pjclavero/Diana/hardware/electronics/schematics/02-esp32-w5500.md

# Hoja 02 — ESP32-S3 y Ethernet W5500

> **SIN VALIDAR.** ERC no ejecutado. Dosier §8.2, §8.3, §8.4, §12 y §28.2.
> El pinout depende del cálculo [`03-presupuesto-gpio.md`](../calculations/03-presupuesto-gpio.md),
> que concluye que **la topología literal del dosier §8.4 no cabe** y adopta la
> topología B.

## 1. Lista de componentes

| Ref. | Valor / tipo | Encapsulado | Función |
|---|---|---|---|
| **U10** | **ESP32-S3-WROOM-1-N16R8** (16 MB flash, 8 MB PSRAM octal) | Módulo SMD | Controlador **(V)**: confirmar variante de PSRAM, ver cálculo 03 §1.2 |
| **U11** | **W5500** | LQFP-48 | Controlador Ethernet con pila TCP/IP |
| Y1 | Cristal **25,000 MHz**, ±30 ppm, C_L 12 pF | 3225 | Reloj del W5500 (obligatorio) |
| C20, C21 | 22 pF NP0 | 0603 | Carga de Y1. **(V)** ajustar tras medir la frecuencia real |
| R20 | 10 kΩ | 0603 | Pull-up de `W5500_RSTn` |
| R21 | 10 kΩ | 0603 | Pull-up de `W5500_INTn` (salida en colector abierto) |
| C22 | 100 nF | 0603 | RC de reset del W5500 con R20: τ = 1,0 ms > 500 µs exigidos |
| R22, R23, R24 | 22 Ω | 0603 | Serie en SCLK, MOSI y nCS_W5500 (control de flancos, EMI) |
| R25–R28 | **49,9 Ω 1 %** | 0603 | Terminación de los pares TX y RX (4 unidades) |
| C23 | **10 nF / 2 kV** X7R | 1206 | Terminación Bob Smith: nodo común de las 4 terminaciones → `CHASSIS` |
| D20 | Array TVS 4 canales para Ethernet, C ≤ 3 pF, ej. SP3012-04UTG | SOT-23-6 | Protección ESD del puerto (dosier §8.3) |
| L20 | Ferrita 600 Ω @ 100 MHz | 0805 | Aísla el 3,3 V del W5500 |
| C24–C31 | 8 × 100 nF | 0402/0603 | Desacoplo, **uno por pin de alimentación del W5500** |
| C32 | 22 µF / 10 V X7R | 0805 | Bulk local del W5500 |
| C33 | 10 µF / 10 V X7R | 0805 | Bulk local del ESP32-S3 |
| C34, C35 | 100 nF | 0402 | Desacoplo del ESP32-S3, junto a cada pin 3V3 |
| R29 | 10 kΩ | 0603 | Pull-up de `EN` del ESP32-S3 |
| C36 | 1 µF | 0603 | RC de `EN`: τ = 10 kΩ × 1 µF = **10 ms** |
| R30 | 10 kΩ | 0603 | Pull-up de `IO0` (BOOT) |
| C37 | 100 nF | 0603 | Antirrebote de SW_BOOT |
| SW_RST | Pulsador táctil 6×6 mm | THT/SMD | Reset |
| SW_BOOT | Pulsador táctil 6×6 mm | THT/SMD | Descarga de firmware |
| R31 | 10 kΩ | 0603 | Pull-up de `IO45` a masa — **VÉASE NOTA CRÍTICA §4** |
| J2 | RJ45 con magnetismos integrados y LED (HR911105A o J0011D01BNL) | THT | Puerto Ethernet (en hoja 08) |
| TP10–TP19 | Pin de prueba | THT | ver §6 |

## 2. Conexionado — bus SPI compartido

El W5500 y el ADC externo de la hoja 05 **comparten** SCLK/MOSI/MISO. El
arbitraje es por chip select.

| Red | ESP32-S3 | W5500 | ADC (hoja 05) | Serie |
|---|---|---|---|---|
| `SPI_SCLK` | IO12 | SCLK (pin 32) | SCLK | R22 22 Ω |
| `SPI_MOSI` | IO11 | MOSI (pin 33) | DIN | R23 22 Ω |
| `SPI_MISO` | IO13 | MISO (pin 34) | DOUT | — |
| `nCS_W5500` | IO10 | SCSn (pin 31) | — | R24 22 Ω |
| `nCS_ADC` | IO14 | — | CSn | — |
| `W5500_INTn` | IO9 | INTn (pin 30) | — | pull-up R21 10 kΩ |
| `W5500_RSTn` | IO8 | RSTn (pin 29) | — | pull-up R20 10 kΩ + C22 100 nF |

**Velocidad de reloj SPI adoptada: 20 MHz.** El W5500 admite hasta 33,3 MHz
según hoja de datos, pero con dos esclavos en el mismo bus y pistas no
controladas en impedancia, 20 MHz da margen. **(V)** Verificar la integridad de
la señal con analizador lógico y, si es necesario, bajar a 10 MHz.

**Requisito de reset del W5500:** RSTn debe mantenerse bajo ≥ 500 µs. El RC
R20/C22 da τ = 1,0 ms al arrancar, y además `IO8` puede forzarlo por firmware.

## 3. Interfaz completa del ESP32-S3 (topología B)

| GPIO | Red | Dirección | Destino |
|---:|---|---|---|
| IO1 | `VSENSE_12V` | entrada ADC1_CH0 | hoja 01 |
| IO2 | *reserva* | — | pin de prueba TP19 |
| IO4 | `LED_D1_3V3` | salida (RMT) | hoja 06, fila superior |
| IO5 | `LED_D2_3V3` | salida (RMT) | hoja 06, fila central |
| IO6 | `LED_D3_3V3` | salida (RMT) | hoja 06, fila inferior |
| IO7 | `IRQ_ANY` | entrada, IRQ por flanco de bajada | hoja 04 |
| IO8 | `W5500_RSTn` | salida | U11 |
| IO9 | `W5500_INTn` | entrada | U11 |
| IO10 | `nCS_W5500` | salida | U11 |
| IO11 | `SPI_MOSI` | salida | U11, hoja 05 |
| IO12 | `SPI_SCLK` | salida | U11, hoja 05 |
| IO13 | `SPI_MISO` | entrada | U11, hoja 05 |
| IO14 | `nCS_ADC` | salida | hoja 05 |
| IO15 | `SEL_A` | entrada, pull-up | hoja 07 |
| IO16 | `SEL_B` | entrada, pull-up | hoja 07 |
| IO17 | `BTN_ID` | entrada, pull-up | hoja 07 |
| IO18 | `ST_LED_G` | salida | hoja 07 |
| IO21 | `VREF_TH_PWM` | salida PWM | hoja 04, filtro RC → umbral |
| IO38 | `SR_DATA` | entrada | hoja 04 (QH del 74HC165) |
| IO39 | `ST_LED_A` | salida | hoja 07. **Consume MTCK** |
| IO47 | `SR_LOAD` | salida | hoja 04 |
| IO48 | `SR_CLK` | salida | hoja 04 |
| IO40, IO41, IO42 | *reserva* | — | pines de prueba TP16–TP18. **Son JTAG** |
| IO19, IO20 | **libres** | USB-Serial-JTAG nativo | no llevados a ningún sitio |
| IO43, IO44 | U0TXD / U0RXD | — | cabezal de programación J30 (hoja 08) |
| IO0 | BOOT | — | R30 + SW_BOOT + C37 |
| EN | RESET | — | R29 + C36 + SW_RST |
| IO3, IO45, IO46 | **no usados** | strapping | ver §4 |
| IO35, IO36, IO37 | **no usados** | PSRAM octal | ver §4 |

## 4. NOTA CRÍTICA sobre pines de arranque

| Pin | Estado exigido en el arranque | Implementación |
|---|---|---|
| `IO0` | Alto para arranque normal; bajo para descarga | R30 pull-up 10 kΩ a `+3V3`, SW_BOOT a `GND_LOG`, C37 100 nF |
| `EN` | Bajo ≥ 1 ms y luego alto | R29 10 kΩ a `+3V3` + C36 1 µF ⇒ τ = 10 ms |
| `IO45` (`VDD_SPI`) | **BAJO** (flash de 3,3 V) | **No conectar nada** y **añadir R31 = 10 kΩ a `GND_LOG`** para garantizarlo |
| `IO46` | Bajo en el arranque | No conectar. Pull-down interno del módulo **(V)**: confirmar en hoja de datos |
| `IO3` | Indiferente si el eFuse de JTAG está por defecto | No conectar |
| `IO35`, `IO36`, `IO37` | Dedicados a la PSRAM octal | **NO CONECTAR NADA.** Rutarlos destruye el arranque |

**Este cuadro es una de las causas típicas de que una placa nueva no arranque.
Debe reverificarse contra la hoja de datos de la revisión exacta del módulo
adquirido antes de fabricar (V).**

## 5. Ethernet — capa física

### 5.1 Conexionado de los pares

| Red | W5500 | R terminación | J2 (RJ45) | D20 |
|---|---|---|---|---|
| `ETH_TXP` | TXP (pin 3) | R25 49,9 Ω → nodo `BOB` | pin 1 | canal 1 |
| `ETH_TXN` | TXN (pin 2) | R26 49,9 Ω → nodo `BOB` | pin 2 | canal 2 |
| `ETH_RXP` | RXP (pin 5) | R27 49,9 Ω → nodo `BOB` | pin 3 | canal 3 |
| `ETH_RXN` | RXN (pin 6) | R28 49,9 Ω → nodo `BOB` | pin 6 | canal 4 |
| `BOB` | — | nodo común de R25–R28 | — | → C23 (10 nF/2 kV) → `CHASSIS` |

Terminación **Bob Smith**: los cuatro 49,9 Ω se unen en un nodo común que se
acopla al chasis mediante C23. Esto da camino de retorno de modo común a las
corrientes del cable sin unir galvánicamente `GND_LOG` y `CHASSIS`.

Los pines 4, 5, 7 y 8 del RJ45 (pares no usados en 10/100BASE-T) se terminan con
75 Ω a un nodo común acoplado por otro condensador de 10 nF/2 kV a `CHASSIS`.
**(V)** — algunos RJ45 con magnetismos ya lo llevan internamente; comprobar la
hoja de datos del conector elegido antes de duplicarlo.

### 5.2 Reglas de layout obligatorias (para el WP de PCB)

1. Los pares TX y RX **diferenciales**, con impedancia diferencial de **100 Ω**,
   longitudes emparejadas dentro de **±0,5 mm** dentro de cada par.
2. Plano de masa continuo bajo los pares **hasta** los magnetismos, y **hueco**
   (sin cobre en ninguna capa) bajo y más allá de los magnetismos, hacia el lado
   del conector.
3. Separación entre los pares TX y RX ≥ 3× la anchura de pista.
4. Sin vías en los pares si es evitable.
5. Y1 con su cristal a menos de 5 mm del W5500 y con guarda de masa.
6. C24–C31 a menos de 2 mm de cada pin de alimentación.

**Ninguna de estas reglas se ha verificado: no hay layout.**

### 5.3 Alimentación del W5500

| Nodo | Conexiones |
|---|---|
| `+3V3` | → L20.1 |
| `+3V3_ETH` | L20.2 → C32 (22 µF), C24–C31 (100 nF ×8), todos los pines V_CC del W5500 |
| `GND_LOG` | Todos los pines GND del W5500 y el pad térmico |

El W5500 lleva regulador interno de 1,2 V para el núcleo; sus pines
`VDD_1V2`/`VBG` se desacoplan según la hoja de datos del fabricante **(V)**.

### 5.4 Identidad de red

El dosier §8.3 y §12.3 exigen **dirección MAC única**. El W5500 **no** trae MAC
en fábrica. Opciones:

1. **EEPROM de MAC precargada** (24AA02E48, I²C) — cuesta 2 GPIO de la reserva.
   **No hay 2 GPIO libres sin restricciones** (cálculo 03 §3.2).
2. **Derivar la MAC del MAC base de fábrica del ESP32-S3**, que sí es único y
   está en eFuse, aplicando el offset de interfaz. **RECOMENDADA:** coste cero en
   hardware y unicidad garantizada por Espressif.
3. Grabar la MAC en NVS durante la fabricación. Requiere proceso de producción.

**Adoptada la opción 2.** Debe confirmarse con WP-04 (firmware) que el MAC base
de eFuse es accesible y que se usa un OUI admisible.

## 6. Puntos de prueba

| TP | Red | Criterio de aceptación |
|---|---|---|
| TP10 | `+3V3_ETH` | 3,25 – 3,35 V, rizado < 30 mV_pp |
| TP11 | `SPI_SCLK` | Reloj limpio a 20 MHz, sobreoscilación < 0,5 V |
| TP12 | `nCS_W5500` | Pulsos válidos, nivel alto ≥ 2,6 V |
| TP13 | `W5500_INTn` | Alto en reposo, bajo con paquete pendiente |
| TP14 | `W5500_RSTn` | Bajo ≥ 500 µs al arrancar |
| TP15 | Y1 | 25,000 MHz ±30 ppm (con punta de baja capacidad) |
| TP16–TP18 | IO40–IO42 | pines de reserva accesibles |
| TP19 | IO2 | pin de reserva accesible |

## 7. Riesgos específicos de esta hoja

1. **Presupuesto de GPIO sin holgura real** (cálculo 03). Cualquier función nueva
   obliga a rediseñar.
2. **Pines de arranque:** un error aquí produce una placa que no arranca y que no
   se puede depurar fácilmente. Es el punto que más se beneficia de una revisión
   humana antes de fabricar.
3. **Integridad de señal de Ethernet** sin impedancia controlada verificada.
4. **Dos esclavos en un mismo bus SPI:** si el ADC externo o el W5500 no liberan
   correctamente MISO, se bloquea la comunicación. **(V)**
5. **Variante de PSRAM desconocida** hasta que se compre el módulo.
