pjclavero/Diana/hardware/electronics/kicad/.gitkeep.md

# hardware/electronics/kicad

Pendiente: lo rellena el paquete de trabajo propietario (ver docs/coordination/OWNERSHIP.md).
