pjclavero/Diana/hardware/electronics/schematics/.gitkeep.md

# hardware/electronics/schematics

Pendiente: lo rellena el paquete de trabajo propietario (ver docs/coordination/OWNERSHIP.md).
