pjclavero/Diana/hardware/mechanical/cad/.gitkeep.md

# hardware/mechanical/cad

Pendiente: lo rellena el paquete de trabajo propietario (ver docs/coordination/OWNERSHIP.md).
