pjclavero/Diana/docs/hardware/.gitkeep.md

# docs/hardware

Pendiente: lo rellena el paquete de trabajo propietario (ver docs/coordination/OWNERSHIP.md).
