pjclavero/Diana/hardware/electronics/calculations/.gitkeep.md

# hardware/electronics/calculations

Pendiente: lo rellena el paquete de trabajo propietario (ver docs/coordination/OWNERSHIP.md).
