pjclavero/Diana/hardware/mechanical/drawings/.gitkeep.md

# hardware/mechanical/drawings

Pendiente: lo rellena el paquete de trabajo propietario (ver docs/coordination/OWNERSHIP.md).
