pjclavero/Diana/scripts/.gitkeep.md

# scripts

Pendiente: lo rellena el paquete de trabajo propietario (ver docs/coordination/OWNERSHIP.md).
