pjclavero/Diana/contracts/api/.gitkeep.md

# contracts/api

Pendiente: lo rellena el paquete de trabajo propietario (ver docs/coordination/OWNERSHIP.md).
