pjclavero/Diana/contracts/events/.gitkeep.md

# contracts/events

Pendiente: lo rellena el paquete de trabajo propietario (ver docs/coordination/OWNERSHIP.md).
