pjclavero/Diana/docs/api/.gitkeep.md

# docs/api

Pendiente: lo rellena el paquete de trabajo propietario (ver docs/coordination/OWNERSHIP.md).
