pjclavero/Diana/docs/deployment/.gitkeep.md

# docs/deployment

Pendiente: lo rellena el paquete de trabajo propietario (ver docs/coordination/OWNERSHIP.md).
