pjclavero/Diana/docs/firmware/.gitkeep.md

# docs/firmware

Pendiente: lo rellena el paquete de trabajo propietario (ver docs/coordination/OWNERSHIP.md).
