pjclavero/Diana/infrastructure/provisioning/.gitkeep.md

# infrastructure/provisioning

Pendiente: lo rellena el paquete de trabajo propietario (ver docs/coordination/OWNERSHIP.md).
