pjclavero/Diana/infrastructure/vm/.gitkeep.md

# infrastructure/vm

Pendiente: lo rellena el paquete de trabajo propietario (ver docs/coordination/OWNERSHIP.md).
