pjclavero/Diana/server/backend/.gitkeep.md

# server/backend

Pendiente: lo rellena el paquete de trabajo propietario (ver docs/coordination/OWNERSHIP.md).
