pjclavero/Diana/server/database/.gitkeep.md

# server/database

Pendiente: lo rellena el paquete de trabajo propietario (ver docs/coordination/OWNERSHIP.md).
