pjclavero/Diana/server/worker/.gitkeep.md

# server/worker

Pendiente: lo rellena el paquete de trabajo propietario (ver docs/coordination/OWNERSHIP.md).
