pjclavero/Diana/hardware/electronics/bom/.gitkeep.md

# hardware/electronics/bom

Pendiente: lo rellena el paquete de trabajo propietario (ver docs/coordination/OWNERSHIP.md).
