pjclavero/Diana/hardware/mechanical/materials/.gitkeep.md

# hardware/mechanical/materials

Pendiente: lo rellena el paquete de trabajo propietario (ver docs/coordination/OWNERSHIP.md).
