pjclavero/Diana/docs/operations/.gitkeep.md

# docs/operations

Pendiente: lo rellena el paquete de trabajo propietario (ver docs/coordination/OWNERSHIP.md).
