pjclavero/Diana/docs/testing/.gitkeep.md

# docs/testing

Pendiente: lo rellena el paquete de trabajo propietario (ver docs/coordination/OWNERSHIP.md).
