pjclavero/Diana/tests/e2e/.gitkeep.md

# tests/e2e

Pendiente: lo rellena el paquete de trabajo propietario (ver docs/coordination/OWNERSHIP.md).
