pjclavero/Diana/tests/fixtures/.gitkeep.md

# tests/fixtures

Pendiente: lo rellena el paquete de trabajo propietario (ver docs/coordination/OWNERSHIP.md).
