pjclavero/Diana/tests/integration/.gitkeep.md

# tests/integration

Pendiente: lo rellena el paquete de trabajo propietario (ver docs/coordination/OWNERSHIP.md).
