pjclavero/Diana/tests/load/.gitkeep.md

# tests/load

Pendiente: lo rellena el paquete de trabajo propietario (ver docs/coordination/OWNERSHIP.md).
