pjclavero/Diana/tests/security/.gitkeep.md

# tests/security

Pendiente: lo rellena el paquete de trabajo propietario (ver docs/coordination/OWNERSHIP.md).
