pjclavero/Diana/hardware/electronics/test-fixtures/.gitkeep.md

# hardware/electronics/test-fixtures

Pendiente: lo rellena el paquete de trabajo propietario (ver docs/coordination/OWNERSHIP.md).
