pjclavero/Diana/hardware/mechanical/tests/.gitkeep.md

# hardware/mechanical/tests

Pendiente: lo rellena el paquete de trabajo propietario (ver docs/coordination/OWNERSHIP.md).
