pjclavero/Diana/firmware/esp32/components/diana_core/src/sha256.c

#include "diana/sha256.h"

#include <string.h>

static const uint32_t K[64] = {
    0x428a2f98u, 0x71374491u, 0xb5c0fbcfu, 0xe9b5dba5u, 0x3956c25bu, 0x59f111f1u,
    0x923f82a4u, 0xab1c5ed5u, 0xd807aa98u, 0x12835b01u, 0x243185beu, 0x550c7dc3u,
    0x72be5d74u, 0x80deb1feu, 0x9bdc06a7u, 0xc19bf174u, 0xe49b69c1u, 0xefbe4786u,
    0x0fc19dc6u, 0x240ca1ccu, 0x2de92c6fu, 0x4a7484aau, 0x5cb0a9dcu, 0x76f988dau,
    0x983e5152u, 0xa831c66du, 0xb00327c8u, 0xbf597fc7u, 0xc6e00bf3u, 0xd5a79147u,
    0x06ca6351u, 0x14292967u, 0x27b70a85u, 0x2e1b2138u, 0x4d2c6dfcu, 0x53380d13u,
    0x650a7354u, 0x766a0abbu, 0x81c2c92eu, 0x92722c85u, 0xa2bfe8a1u, 0xa81a664bu,
    0xc24b8b70u, 0xc76c51a3u, 0xd192e819u, 0xd6990624u, 0xf40e3585u, 0x106aa070u,
    0x19a4c116u, 0x1e376c08u, 0x2748774cu, 0x34b0bcb5u, 0x391c0cb3u, 0x4ed8aa4au,
    0x5b9cca4fu, 0x682e6ff3u, 0x748f82eeu, 0x78a5636fu, 0x84c87814u, 0x8cc70208u,
    0x90befffau, 0xa4506cebu, 0xbef9a3f7u, 0xc67178f2u,
};

#define ROR(x, n) (((x) >> (n)) | ((x) << (32 - (n))))

static void compress(diana_sha256 *c, const uint8_t block[64])
{
    uint32_t w[64];
    for (int i = 0; i < 16; ++i) {
        w[i] = ((uint32_t)block[i * 4] << 24) | ((uint32_t)block[i * 4 + 1] << 16) |
               ((uint32_t)block[i * 4 + 2] << 8) | (uint32_t)block[i * 4 + 3];
    }
    for (int i = 16; i < 64; ++i) {
        uint32_t s0 = ROR(w[i - 15], 7) ^ ROR(w[i - 15], 18) ^ (w[i - 15] >> 3);
        uint32_t s1 = ROR(w[i - 2], 17) ^ ROR(w[i - 2], 19) ^ (w[i - 2] >> 10);
        w[i] = w[i - 16] + s0 + w[i - 7] + s1;
    }

    uint32_t a = c->state[0], b = c->state[1], cc = c->state[2], d = c->state[3];
    uint32_t e = c->state[4], f = c->state[5], g = c->state[6], h = c->state[7];

    for (int i = 0; i < 64; ++i) {
        uint32_t S1 = ROR(e, 6) ^ ROR(e, 11) ^ ROR(e, 25);
        uint32_t ch = (e & f) ^ ((~e) & g);
        uint32_t t1 = h + S1 + ch + K[i] + w[i];
        uint32_t S0 = ROR(a, 2) ^ ROR(a, 13) ^ ROR(a, 22);
        uint32_t maj = (a & b) ^ (a & cc) ^ (b & cc);
        uint32_t t2 = S0 + maj;
        h = g; g = f; f = e; e = d + t1;
        d = cc; cc = b; b = a; a = t1 + t2;
    }

    c->state[0] += a; c->state[1] += b; c->state[2] += cc; c->state[3] += d;
    c->state[4] += e; c->state[5] += f; c->state[6] += g; c->state[7] += h;
}

void diana_sha256_init(diana_sha256 *c)
{
    c->state[0] = 0x6a09e667u; c->state[1] = 0xbb67ae85u;
    c->state[2] = 0x3c6ef372u; c->state[3] = 0xa54ff53au;
    c->state[4] = 0x510e527fu; c->state[5] = 0x9b05688cu;
    c->state[6] = 0x1f83d9abu; c->state[7] = 0x5be0cd19u;
    c->bitlen = 0;
    c->buflen = 0;
}

void diana_sha256_update(diana_sha256 *c, const void *data, size_t len)
{
    const uint8_t *p = (const uint8_t *)data;
    c->bitlen += (uint64_t)len * 8;
    while (len > 0) {
        size_t take = 64 - c->buflen;
        if (take > len) take = len;
        memcpy(c->buf + c->buflen, p, take);
        c->buflen += take;
        p += take;
        len -= take;
        if (c->buflen == 64) {
            compress(c, c->buf);
            c->buflen = 0;
        }
    }
}

void diana_sha256_final(diana_sha256 *c, uint8_t out[32])
{
    uint64_t bits = c->bitlen;
    uint8_t pad = 0x80;
    diana_sha256_update(c, &pad, 1);
    c->bitlen = bits; /* el padding no cuenta */
    uint8_t zero = 0x00;
    while (c->buflen != 56) {
        diana_sha256_update(c, &zero, 1);
        c->bitlen = bits;
    }
    uint8_t len_be[8];
    for (int i = 0; i < 8; ++i) len_be[i] = (uint8_t)(bits >> (56 - i * 8));
    diana_sha256_update(c, len_be, 8);

    for (int i = 0; i < 8; ++i) {
        out[i * 4]     = (uint8_t)(c->state[i] >> 24);
        out[i * 4 + 1] = (uint8_t)(c->state[i] >> 16);
        out[i * 4 + 2] = (uint8_t)(c->state[i] >> 8);
        out[i * 4 + 3] = (uint8_t)(c->state[i]);
    }
}

void diana_sha256_hex(const void *data, size_t len, char out[65])
{
    static const char HEX[] = "0123456789abcdef";
    uint8_t digest[32];
    diana_sha256 c;
    diana_sha256_init(&c);
    diana_sha256_update(&c, data, len);
    diana_sha256_final(&c, digest);
    for (int i = 0; i < 32; ++i) {
        out[i * 2]     = HEX[(digest[i] >> 4) & 0x0F];
        out[i * 2 + 1] = HEX[digest[i] & 0x0F];
    }
    out[64] = '\0';
}
