pjclavero/Diana/(commit log)

2026-07-20 feat(w0): fundación del repositorio y contratos MQTT v1 congelados
    Estructura profesional con separación inequívoca firmware/servidor/contratos,
    contratos MQTT v1 (12 esquemas, 16 ejemplos válidos, 12 inválidos) con validador
    ejecutable, ADR 0001-0006 y documentos de coordinación del programa.
    El modelo temporal de cuatro marcas queda impuesto por contrato: los tiempos de
    recepción y persistencia del servidor no viajan en el payload MQTT, y hay un
    ejemplo inválido que lo comprueba.
    Evidencia: python3 contracts/validate.py -> 41 comprobaciones, 0 fallos.
2026-07-20 docs(arch): vista de arquitectura y decisión de memoria de la VM 109
    Registra la decisión del usuario sobre el balloon de la VM (4 GB con mínimo 1 GB)
    tras medir que el nodo ya está sobrecomprometido, y consolida la arquitectura de
    las tres autoridades separadas.
2026-07-20 feat(infra): añade la infraestructura Docker completa de WP-01
    Stack Compose para Diana con proxy (nginx), frontend, backend, worker,
    postgres, mosquitto, migrate y backup, más perfiles simulator/dev/test/
    monitoring. Healthchecks en todos los servicios persistentes, redes
    edge/internal con postgres sin publicar y mosquitto publicando sólo 1883,
    volúmenes nombrados persistentes, límites de recursos ajustados a 4 vCPU/
    4 GB, imágenes con versión fijada y restart policies. compose.dev.yml añade
    puertos de depuración y bind mounts; .env.example documenta todas las
    variables y cómo generar secretos sin embeberlos.
    Mosquitto: sin acceso anónimo, ACL que implementa literalmente la secc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
2026-07-20 feat(simulator): implementa el simulador de módulos y dianas (WP-05)
    Sustituto contractual del firmware ESP32 para partidas completas y E2E sin
    hardware: 1..9 módulos simulados (hasta 81 dianas), rol principal/satélite
    con selector SATELITE/AUTO/PRINCIPAL, consolidación de impactos por el
    coordinador (elapsed_us nunca lo calcula el servidor, ADR-0002), vibración
    cruzada con crosstalk_rejected, idempotencia por event_id (ADR-0003),
    desconexión/reconexión con Last Will y reenvío de cola (replay=true), baja
    tensión, reinicio con boot_id nuevo y local_sequence persistente, firmwares
    distintos, telemetría periódica y autojugador configurable.
    Escenarios deterministas por semilla (JSON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
2026-07-20 docs(supervisor): dictamen de la puerta Ola 0
    NO CONFORME. Dos bloqueantes: la ACL de MQTT es incompatible con la tabla
    de topicos del propio contrato (la consolidacion de impactos es inejecutable
    y de esa ACL depende el cierre real de ADR-0002), y los $ref de los doce
    esquemas solo resuelven con el validador propio.
    Cinco mayores: faltan los modos memory y no_shoot del dosier 16.5/16.6 en un
    enum congelado, la Ola 0 figura APPROVED sin dictamen previo, la caducidad de
    comandos no protege contra reproduccion, "el encargo" no esta en el repositorio
    pese a sostener la unica correccion sustantiva al dosier, y module-command no
    valida parametros por accion.
    Evidencia: validate.py 41/0, prueba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
2026-07-20 hw(electronics): proyecto KiCad jerarquico con las 8 hojas y netlist transcribible
    Estructura KiCad 8 (s-expression) del modulo 3x3: fichero de proyecto con
    clases de red predimensionadas, hoja raiz con las 8 sub-hojas del dosier §28 y
    sus pines jerarquicos, y las 8 hojas hijas. La hoja 04 instancia 9 veces la
    hoja 03 (reutilizacion jerarquica real, no nueve copias).
    SIN VALIDAR: no hay KiCad en el entorno (kicad-cli, kicad, eeschema, pcbnew y
    el modulo python pcbnew: todos NO ENCONTRADOS). No se ha ejecutado ERC ni DRC
    ni se ha abierto ningun fichero. Lo unico comprobado con herramientas propias:
    balance de parentesis (9/9 a profundidad 0), parseo completo como s-expression
    (9/9, raiz kic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
    [01-power.kicad_sch, 02-esp32-w5500.kicad_sch, 03-piezo-channel.kicad_sch, 04-piezo-array-9ch.kicad_sch, 05-analog-mux-or-adc.kicad_sch, 06-led-level-shifting.kicad_sch, 07-user-inputs.kicad_sch, 08-connectors.kicad_sch]
2026-07-20 hw(electronics): esquemas textuales completos de las 8 hojas del dosier §28
    Descripcion nodo a nodo, sin ambiguedad, de las 8 hojas: cada componente con
    referencia, valor, encapsulado y funcion; cada conexion; cada punto de prueba.
    Fuente normativa del conexionado (manda sobre los ficheros KiCad).
    01 alimentacion: 12V, SW bipolar, fusible T3,15A, NTC de inrush, antipolaridad
    con PMOS (68 mV frente a 0,9 V de un Schottky), TVS SMBJ15A, filtro, buck
    12->5V 6A, buck 5->3V3, ferrita a +3V3A, divisores de medida, punto estrella
    de masas, trazabilidad de las 12 protecciones del dosier §11.3.
    02 ESP32-S3 + W5500: SPI compartido a 20 MHz, CS/INT/RESET, cristal 25 MHz,
    RJ45 con magneti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
2026-07-20 hw(electronics): calculos de potencia, cadena piezo, GPIO y termica
    Cuatro calculos con las operaciones a la vista y reproducibles.
    01 Potencia LED: 72 x 60 mA = 4,320 A; con logica 4,870 A / 24,35 W; convertidor
    de 6 A al 81,2 % (uno de 5 A dejaria 2,6 % y queda descartado); entrada de
    12 V a 2,255 A con eta 0,90 (75,2 % de la fuente de 3 A). Bulk: 1 528 uF
    calculados -> 2 000 uF adoptados, con ESR <= 26,2 mohm como requisito de
    compra. Cable de 0,75 mm2 (0,067 V a 1 m); pista de 2,0 mm a 1 oz por
    IPC-2221 (98,5 mil2 para 5 A y dT 20 C); caida total prevista 0,173 V.
    02 Cadena piezo: energia del pulso 225 uJ a 150 V; corriente por el clamp
    2,152 mA; tau de descarga 20,0 m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
2026-07-20 fix(contracts): la ACL concede escritura tópico a tópico, no por comodín
    Hallazgo del equipo de infraestructura (WP-01): la sección 8 decía que un módulo
    escribe bajo 'module/{su_id}/#', lo que contradecía la tabla de la sección 2 y le
    habría permitido escribir su propio config/desired y su canal ota. Un módulo
    comprometido podría auto-otorgarse configuración.
    Se enumeran los permisos tópico a tópico y se fija que el client_id MQTT debe
    coincidir con el module_id, que es de lo que depende el patrón %c de la ACL.
2026-07-20 hw(electronics): BOM preliminar con alternativas y protocolo de prueba en banco
    BOM de 58 lineas en CSV con referencias, cantidades, valores, encapsulados, dos
    alternativas por linea, marca de criticidad y notas tecnicas de sustitucion.
    SIN PRECIOS: no hay forma de verificar catalogos, existencias ni plazos en este
    entorno, y poner cifras inventadas en un documento de compra seria peor que no
    ponerlas. Se documentan los 8 componentes donde una sustitucion "equivalente"
    rompe el diseno (HC en vez de HCT, comparador push-pull en vez de colector
    abierto, diodo de silicio en vez de Schottky en el clamp, electrolitico generico
    en vez de low-ESR, 0603 de 50 V en la serie del piezo, condensador de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
    [bom-modulo-3x3-preliminar.csv]
2026-07-20 hw(mechanical): materiales, aislamiento de vibraciones y protocolo de impacto
    Policarbonato de 2/3/4 mm como material prioritario (el metacrilato queda
    prohibido en configuraciones con impacto real por su rotura fragil con
    astillado). Masas calculadas: 0,075 / 0,113 / 0,151 kg. Diez ensayos M1-M10 con
    criterios numericos y matriz de cribado, seleccion y confirmacion. Incluye el
    ensayo del adhesivo del piezo, que domina la sensibilidad mas que toda la
    electronica del canal.
    Aislamiento de vibraciones: modelo de un grado de libertad con m = 0,26 kg.
    Objetivo fn = 30 Hz -> k total 9 238 N/m, 2 309 N/m por apoyo, flecha estatica
    0,276 mm y transmisibilidad de 0,00090 a 1 kHz (-60,9 dB). Metodo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
2026-07-20 hw(electronics): notas de diseno, 17 decisiones, 15 riesgos y las 47 validaciones pendientes
    VALIDACION-FISICA-PENDIENTE.md es el documento central del paquete: lista
    explicita y numerada de las 47 validaciones que hay que ejecutar antes de
    fabricar una PCB, agrupadas en 7 bloques (herramienta, alimentacion, termica,
    cadena piezo, controlador y GPIO, integracion, mecanica), cada una con su
    criterio numerico y su fase del protocolo de banco. Incluye una tabla explicita
    de lo que NO se puede afirmar hoy (ERC conforme, DRC conforme, circuito
    validado, PCB fabricable, proteccion del piezo funcional, ficheros KiCad
    abribles) y de lo que si, con su evidencia. De las 10 revisiones que el dosier
    §2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
2026-07-20 feat(firmware): capa de abstraccion de hardware y logica probada en host
    Implementa WP-04. La arquitectura separa la logica de negocio (diana_core,
    C11 portable, sin ESP-IDF) de la capa de hardware mediante una tabla de
    punteros (diana_hal), con dos implementaciones: la real sobre ESP-IDF y una
    de simulacion para PC. Eso permite compilar y EJECUTAR de verdad la parte
    delicada del paquete sin toolchain de Espressif ni hardware.
    diana_core (probado en host, 338 comprobaciones en verde):
    - maquinas de estados del modulo (dosier 13.3) y de cada diana (13.4), con
    tabla de transiciones explicita: lo no declarado se rechaza y se contabiliza
    - cola persistente de eventos no confirmados, con repla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
    [partitions.csv]
2026-07-20 feat(frontend): panel web Diana completo con adaptador mock y contrato de API
    Implementa WP-03: React 19 + TypeScript + Vite, con las 19 pantallas del
    encargo (inicio, estado del sistema, módulos, editor de matriz 3x3 con
    arrastrar/soltar y rotación, calibración, pruebas de sensores y LED,
    jugadores, equipos, creación de partida, cuenta atrás, directo por
    WebSocket, resultados, estadísticas, firmware, incidencias, usuarios y
    copias). Capa de API aislada (DianaApiClient) con adaptador mock completo
    y determinista para trabajar hoy sin backend, y adaptador real listo para
    la Ola 2 cambiando sólo VITE_API_MODE.
    Cumple los requisitos duros: el estado de una diana nunca depende sólo
    del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
2026-07-20 fix(infra): ajusta la ACL de mosquitto al contrato corregido y añade prueba ejecutable
    Trae develop (contracts/mqtt/README.md sección 8 corregida: la ACL de un
    módulo se enumera tópico a tópico en vez de conceder un comodín de
    escritura sobre module/{su_id}/#, que permitía a un módulo comprometido
    escribirse su propio config/desired o publicar en su canal ota).
    infrastructure/mosquitto/acl:
    - Escritura de módulo limitada a presence/status/telemetry/hit/
    diagnostic/config-reported (ya no module/%c/#).
    - command, config/desired y ota pasan a sólo lectura para el módulo,
    sin excepción sobre su propio subárbol.
    - El backend gana escritura explícita sobre .../ota (ant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
2026-07-20 fix(contracts): cierra los bloqueantes H-01 y H-02 del dictamen del supervisor
    H-01 · La consolidación temporal era inejecutable bajo su propia ACL: exigía que
    el coordinador escribiese en 'module/{otro}/hit'. Se fija que ningún módulo escribe
    nunca el tópico de otro; T2 de un satélite viaja en game/event (kind=target_hit)
    enlazado por hit_event_id, y el bloque 'coordinator' del hit-event sólo aparece
    cuando el detector es el propio coordinador.
    H-02 · Los $ref apuntaban a 'common.schema.json', que bajo resolución estándar
    resuelve a contracts/mqtt/common.schema.json, inexistente. Sólo funcionaban por
    una doble base registrada en nuestro validador; ajv y CI habrían fallado. Aho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
2026-07-20 docs(coord): estado real de la Ola 1 y registro de hallazgos cruzados
    Recoge los siete hallazgos que cruzan paquetes, entre ellos que el presupuesto
    de GPIO del dosier no cuadra (29 pines necesarios frente a 25 disponibles): el
    riesgo 'Escasez de GPIO' del dosier 34 se ha materializado.
2026-07-20 feat(backend): esquema, ingesta MQTT idempotente y motor de partidas (WP-02)
    Implementa el paquete WP-02: backend NestJS modular, esquema Prisma con las 23
    entidades del dosier 21.1, ingesta MQTT validada contra el contrato congelado,
    motor de partidas extensible y cálculo de munición y precisión.
    Decisiones normativas aplicadas:
    - ADR-0002 (modelo temporal): `hit_events` guarda T1 (device_*), T2
    (coordinator_*), T3 (received_at) y T4 (persisted_at) en columnas separadas y
    en microsegundos (BIGINT). El backend copia T1 y T2 sin tocarlos; un evento
    fuera de ventana se MARCA (out_of_window + motivo), nunca se corrige.
    - ADR-0003 (idempotencia): índice único sobre event_id y restri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
2026-07-20 fix(firmware): resincroniza con el contrato corregido (H-01, H-02, H-05, H-07)
    Aplica los cambios del dictamen del supervisor tras fusionar origin/develop.
    H-01 · Ningun modulo escribe en el topico de otro. El coordinador ya no
    "reenriquece" el hit del satelite; la regla se impone en codigo, no solo en
    documentacion:
    - diana_hit_event_attach_coordinator() se niega a rellenar T2 si el modulo no
    es principal o si el evento pertenece a otro module_id
    - diana_game_event_target_hit() publica T2 en system/{sys}/game/event con
    kind=target_hit y hit_event_id enlazando con el hit original; rechaza el
    mensaje si el emisor no es coordinador o si falta el enlace (T2 huerfano)
    - el game-event lle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
    [app_commands.c, app_main.c, command.c, command.h, event.c, event.h, hal_esp32.c, main.c]
2026-07-20 fix(simulator): resincroniza con develop y corrige los hallazgos H-01/H-02 del dictamen NO CONFORME
    Tras el fetch+merge de origin/develop (contratos actualizados por el
    supervisor), ajusta el simulador a los bloqueantes que le afectaban:
    - H-01: el Coordinator ya no reescribe el hit-event de un satélite en su
    propio tópico (violaba la ACL "ningún módulo escribe en el tópico de
    otro"). Ahora T2 para impactos de satélite viaja exclusivamente por
    game/event (kind=target_hit/penalty_applied) enlazado por hit_event_id;
    el bloque `coordinator` sólo se reincrusta en el hit-event cuando el
    detector es el propio módulo principal (mismo tópico, mismo cliente).
    - H-02: src/contracts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
2026-07-20 fix(contracts): completa H-05 en el texto normativo y ratifica el techo de 15 s
    El commit anterior corrigió las descripciones de los esquemas pero dejó la
    sección 6 del README diciendo todavía 'desde la recepción del canal'. Lo detectó
    el equipo de firmware, que ya había implementado la corrección: el código iba por
    delante del texto.
    Se ratifica además como contrato el techo de 15 s de expires_in_ms para reboot,
    set_maintenance y start_calibration, que el firmware había introducido como
    divergencia deliberada. Es correcta: un reboot con los 600 s que permitía el
    contrato general seguiría siendo reinyectable ocho minutos después.
    Se documenta la consecuencia operativa descubi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
2026-07-20 fix(repo): el patrón 'exports/' del .gitignore excluía código fuente del backend
    Defecto mío de la Ola 0. La línea pretendía ignorar exportaciones de datos, pero
    al no estar anclada excluía también server/backend/src/domain/exports/ y
    src/modules/exports/. Los tests del backend pasaban en su worktree porque los
    ficheros estaban en disco, pero nunca llegaron a git: al integrar, 2 suites no
    compilaban.
    Se ancla el patrón (/exports/) y se recuperan los dos ficheros perdidos.
    Comprobados los seis worktrees en busca del mismo problema: sólo afectaba a este.
    Evidencia tras la corrección, sobre develop integrada:
    backend 157 pasados, 5 saltados (integración, exigen PostgreSQL rea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
2026-07-20 docs(fases): hoja de ruta con el estado real de las 12 fases del dosier
    Ninguna fase que dependa de hardware se marca superada. Se registran las dos
    lagunas mayores: el firmware nunca compilado con ESP-IDF y la migración nunca
    ejecutada contra una base viva.
2026-07-20 feat(vm): scripts de aprovisionamiento y ficha de la VM 109
    Los cinco scripts reproducen lo aplicado a mano sobre diana-server:
    sistema base, Docker Engine desde el repositorio oficial, usuario
    administrativo, endurecimiento de SSH y cortafuegos.
    La ficha registra el estado real, incluida la incidencia de cloud-init
    y el unico paso pendiente de Tailscale (no hay auth key).
2026-07-20 test(fixtures): jugadores de prueba para integracion y E2E
2026-07-20 docs(seguridad): WP-10 a READY_FOR_REVIEW y 8 hallazgos que cruzan paquetes
    Cierra la revisión independiente de seguridad. La fila de WP-10 recoge el
    recuento real (1 crítico, 6 altos, 10 medios, 1 bajo) y deja constancia de que
    ocho hallazgos no se han podido reproducir en ejecución porque el stack no
    arranca: faltan los Dockerfile de backend y worker.
    Se añaden X-08 a X-15 a la tabla de hallazgos que cruzan paquetes, que son los
    que ningún paquete puede cerrar por su cuenta. X-10 (Dockerfile ausentes) ya se
    está resolviendo en WP-08. X-13 documenta la dependencia entre F-14 y F-02: el
    riesgo del acceso físico al módulo sólo es asumible si antes se corrige la ACL.
2026-07-21 docs(seguridad): modelo de amenazas y evidencia recogida
    Consolida el trabajo de la primera sesión de WP-10: el modelo de amenazas
    (activos A1-A7, actores T1-T6, superficie de ataque, límites del modelo) y los
    seis ficheros de evidencia con la salida real de los comandos ejecutados
    (analisis-codigo, firmware-ota, mqtt-acl, npm-audit, secretos-y-gitignore,
    vm-exposicion). Retira el placeholder .gitkeep.md, ya sustituido por contenido.
2026-07-21 docs(seguridad): 18 hallazgos F-01..F-18 con evidencia y dictámenes
    Cierra los hallazgos que el modelo de amenazas ya citaba. Cada uno con
    severidad justificada, activo afectado, evidencia con ruta y línea, reproducción,
    impacto real y mitigación. Se marca OBSERVADO frente a DEDUCIDO en cada hallazgo:
    el stack no estaba en marcha (docker ps vacío, faltan Dockerfile de backend y
    worker), así que todo lo relativo a ejecución está deducido del código, no visto.
    Destacados:
    - F-02 (crítico): la ACL de MQTT autoriza por client_id (%c), elegido por el
    cliente, no por el usuario autenticado; unas credenciales cualesquiera de
    módulo bastan para suplantar a cualquier otro. Falta use_u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
2026-07-21 docs(seguridad): riesgos asumidos R-01..R-05, propuestos y sin firmar
    Distingue lo aceptado a propósito de lo pendiente de corregir. Cada riesgo con
    justificación, condición bajo la que deja de ser aceptable y propietario que
    debe firmarlo. El equipo de seguridad propone; no firma: la aceptación es del
    propietario del sistema. R-03 (custodia física en vez de secure boot) queda
    condicionado a cerrar antes F-02. Sección final que enumera lo que NO se acepta.
2026-07-21 feat(deploy): Dockerfiles multi-stage de backend y worker (F-13)
    Faltaban server/backend/Dockerfile y server/worker/Dockerfile: por eso solo
    se construian 2 de las 4 imagenes. Ambos son multi-stage con base slim fijada
    (node:20.19-bookworm-slim), corren como usuario NO root 'diana', usan
    .dockerignore de raiz para no meter secretos ni node_modules, y el contexto
    de build es la raiz del repo porque:
    - el backend LEE contracts/ en ejecucion (ContractValidator)
    - el worker comparte el esquema Prisma de server/backend/prisma
    El runtime del backend incluye el cliente Prisma generado, los engines y el
    CLI, de modo que 'prisma migrate deploy' se puede ejecutar desde la imagen.
2026-07-21 fix(infra): el contrato de entorno no entregaba JWT_SECRET ni CORS al backend
    Correcciones de wiring en compose.yml/.env para que el stack arranque:
    - JWT_SECRET no llegaba al backend: configuration.ts aborta en produccion sin
    el. Se anade JWT_SECRET=${BACKEND_JWT_SECRET} y se documenta en .env.example.
    - CORS con nombre equivocado: el codigo lee CORS_ORIGINS (plural); compose
    pasaba CORS_ORIGIN. El panel se quedaba sin CORS (origin:false). Corregido.
    - SESSION_SECRET era variable muerta (el backend no la lee): eliminada.
    - Contextos de build de backend/worker/migrate/seed/simulator a la raiz del
    repo con su dockerfile explicito (F-13).
    - Healthchecks reales verificados en codigo:
    *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
2026-07-21 ci(workflows): CI rápido por push/PR (contratos, backend, frontend, worker, simulador, firmware host, compose config) + chequeo de exposición de puertos
2026-07-21 ci(firmware): compilación real ESP-IDF para ESP32-S3 con tamaño y particiones como artefacto
2026-07-21 ci(integracion): postgres+mosquitto, migracion Prisma y tests de integracion del backend
2026-07-21 test(e2e): stack completo con Compose y Playwright; andamiaje de los 16 escenarios (todos placeholder, documentados)
2026-07-21 ci(nightly): carga MQTT (9 modulos/81 dianas), npm audit, gitleaks y Trivy de imagenes
2026-07-21 chore(makefile): objetivos de firmware host, carga y chequeo de puertos; fixture de topologia 3x3
2026-07-21 fix(frontend): resuelve violación de strict mode en el aserto de conexión del directo
    El regex /en directo|conectando/ casaba con el <h1> 'Partida en directo' y
    con el ConnectionBadge, resolviendo a dos elementos. Se añade data-testid
    'connection-badge' al badge y el aserto lo usa de forma inequívoca.
2026-07-21 fix(frontend): vincula vite preview a 127.0.0.1 y usa Chromium en el perfil tableta
    - 'vite preview' se ataba sólo a IPv6 (::1) mientras el baseURL es 127.0.0.1,
    provocando 'Timed out waiting for webServer'. Se fuerza --host 127.0.0.1.
    - El perfil 'tablet' (iPad) usaba WebKit por defecto, no aprovisionado en CI
    (sólo Chromium). Se fija defaultBrowserType chromium manteniendo el viewport.
2026-07-21 fix(frontend): acota los asertos de navegación al menú principal
    getByRole('link', {name:'Editor de matriz'}) casaba por subcadena con el
    enlace de contenido 'Editor de matriz de módulos' de la home (siempre
    visible), en vez del enlace del menú. Se acotan las aserciones a la región
    role=navigation 'Navegación principal'.
2026-07-21 fix(worker): upsert sobre clave única con columnas NULL duplicaba estadísticas
    La clave (scope,metric,playerId,gameId,roundId,periodStart) tiene columnas
    anulables que van a null en la estadística por jugador. En SQL NULL != NULL,
    así que el upsert insertaba una fila nueva en cada ejecución. Se sustituye por
    find-by-null + update/create explícito.
    Rescatado de un hotfix que WP-08 aplicó directamente en la VM sin commitear;
    verificado con typecheck limpio del worker.
2026-07-21 fix(postgres): sin listen_addresses el server sólo escuchaba en localhost
    Con config_file propio y sin declarar listen_addresses, PostgreSQL usa el
    defecto 'localhost': el healthcheck local pasaba (Healthy) pero migrate,
    backend y worker recibían P1001 «Can't reach database server at postgres:5432».
    El stack no podía arrancar. Se fija listen_addresses='*'; la exposición sigue
    limitada por no publicar el puerto al host y por pg_hba.
2026-07-21 fix(mosquitto): socket_domain ipv4 evita el EADDRINUSE dual-stack en Docker
    El listener IPv6 por defecto es dual-stack y se apropia del puerto IPv4; el
    bind IPv4 posterior fallaba con «Address in use» y mosquitto entraba en bucle
    de reinicio (exit 1). Se fuerza IPv4 en ambos listeners (1883 y 9001).
2026-07-21 fix(mosquitto): opciones globales antes del listener creaban un 1883 duplicado
    allow_anonymous/password_file/acl_file y los límites estaban antes del primer
    `listener`, lo que en mosquitto 2.0 crea un «listener por defecto» en 1883 que
    choca con `listener 1883` → «Error: Address in use» y bucle de reinicio. Se
    mueven tras el primer listener (siguen siendo globales con per_listener_settings
    en false). El socket_domain ipv4 se conserva; el diagnóstico previo de dual-stack
    era incorrecto.
2026-07-21 fix(compose): el healthcheck de mosquitto expiraba siempre (sub sin publicador)
    Usaba mosquitto_sub -C 1 -W 3 sobre _health/probe, esperando un mensaje que
    nadie publica: «Timed out» en cada intento y mosquitto quedaba unhealthy pese a
    estar operativo, bloqueando el arranque de backend y worker (depend_on healthy).
    Se cambia a mosquitto_pub, que prueba broker + auth + ACL de escritura.
2026-07-21 fix(proxy): el prefijo global 'api' se descartaba y la API daba 404
    nginx reenviaba /api/ con proxy_pass .../ (barra final), que elimina el prefijo:
    el backend, con setGlobalPrefix('api'), recibía /health en vez de /api/health y
    respondía 404 a toda la API. Se pasa el URI completo (proxy_pass sin ruta) en
    /api/ y /api/auth/, conservando esta última su zona de rate-limit del login.
    Pendiente aún el enrutado WebSocket (/ws vs socket.io namespace /live, X-06).
2026-07-21 docs(despliegue): incidencias reales del primer arranque y evidencia del stack sano
    Cinco defectos que impedían arrancar (postgres listen_addresses, permisos passwd,
    listener duplicado de mosquitto, healthcheck que expiraba, prefijo /api en el
    proxy), con causa raíz, corrección y commit, más la evidencia ejecutada del stack
    healthy y de la API respondiendo por el proxy.
2026-07-21 test(backend): siembra padres FK (game/round) para specs de integración
    Los specs idempotency/temporal insertan hit_events con gameId/roundId no
    nulos del ejemplo valid-hit; contra PostgreSQL real eso viola
    hit_events_game_id_fkey. Se añade helper fk-seed que crea la cadena
    TargetSystem -> GameMode -> Game -> Round en beforeAll y la limpia en
    afterAll. No se toca ningun aserto ni codigo de produccion.
2026-07-21 test(backend): probar la no-truncación BigInt inyectando el valor como BigInt
    El test escribía 9007199254740993 como literal number de JS, que ya se
    redondea a 2^53 antes de llegar al almacenamiento: no medía la columna
    BigInt sino la limitación de double de JS. Se inyecta el valor como BigInt
    en el registro (tipo real de la columna) para demostrar que Prisma y la
    columna BigInt de PostgreSQL lo conservan sin truncar. Aserto intacto.
